TomBeech85/esphome-toshiba-hvac-controller/hardware/integrated/render_check.png

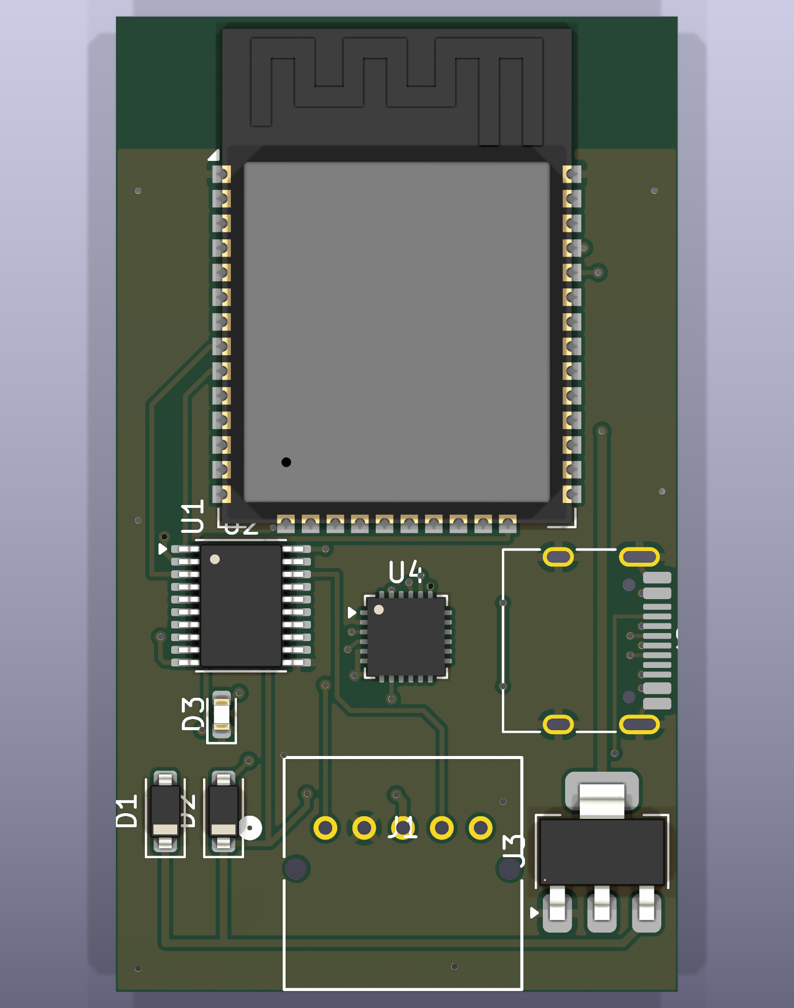
hardware/integrated/render_check.png
