TomBeech85/esphome-toshiba-hvac-controller/hardware/integrated/render_bottom.png

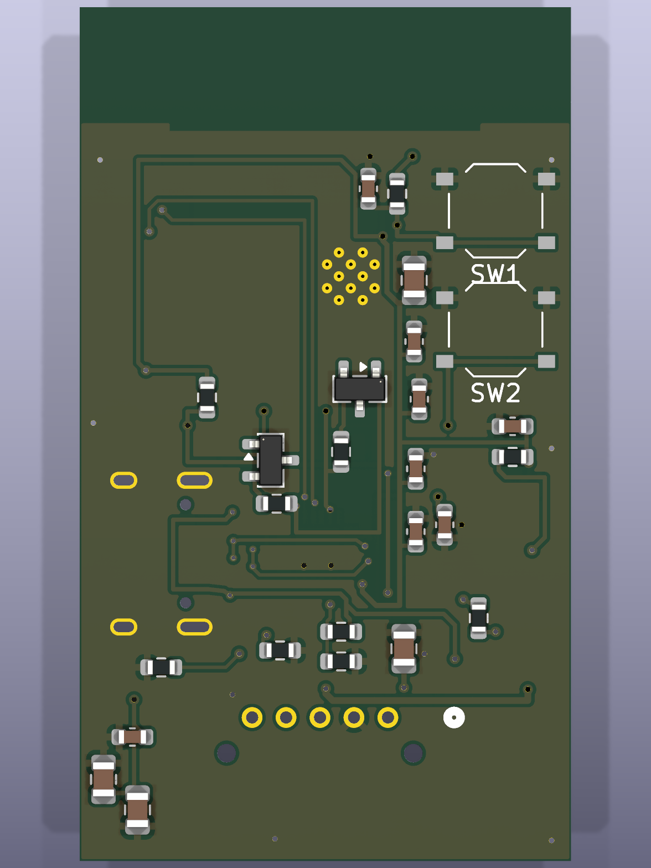
hardware/integrated/render_bottom.png
