TomBeech85/esphome-toshiba-hvac-controller/hardware/integrated/render_top.png

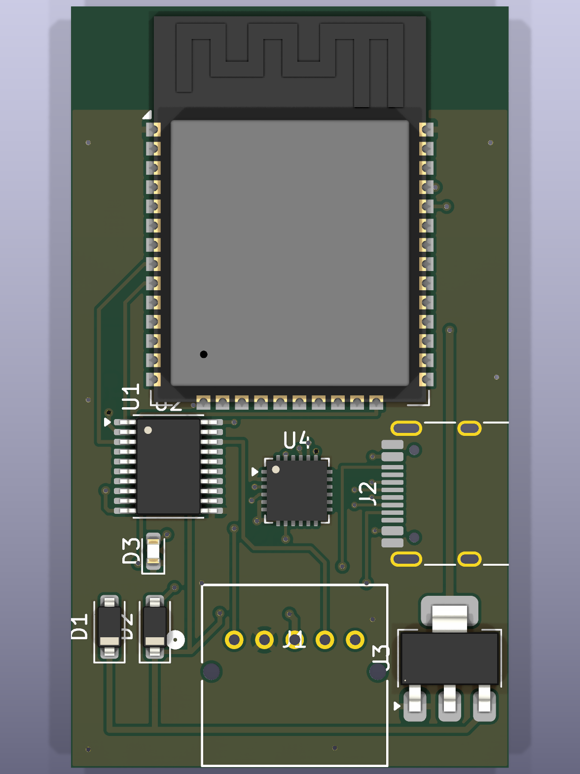
hardware/integrated/render_top.png
