TomBeech85/esphome-toshiba-hvac-controller/hardware/integrated/toshiba_hvac_esp32_integrated.kicad_pcb

## KiCad design hardware/integrated/toshiba_hvac_esp32_integrated.kicad_pcb (2026-08-09)

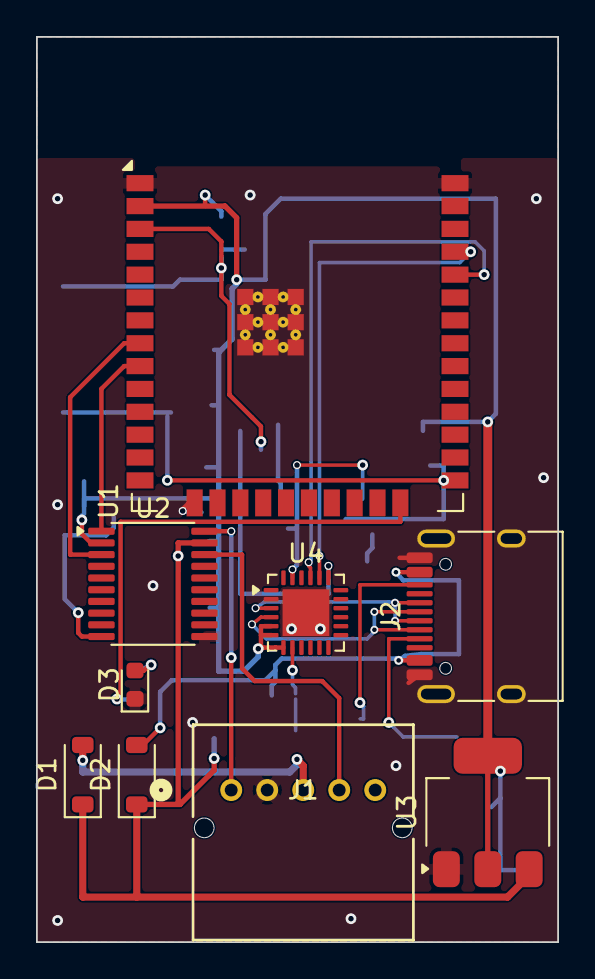
[picture p4: board toshiba_hvac_esp32_integrated.kicad_pcb from above]

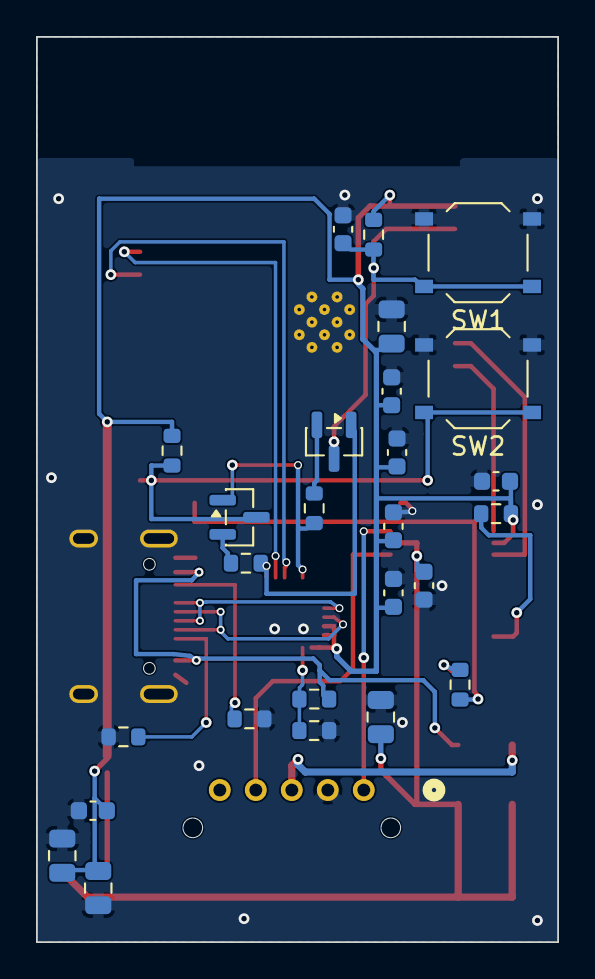
[picture p5: board toshiba_hvac_esp32_integrated.kicad_pcb from below]

Board: 2 copper layers, 29.0 x 50.3 mm, 35 parts (26 on the bottom side), 25 nets.

Parts:
C1, C2, C3, C4, C5, C6: 100nF; C_0603_1608Metric
C7, C8: 1uF; C_0603_1608Metric
C9, C10: 10uF; C_0805_2012Metric
C11, C12: 22uF; C_0805_2012Metric
D1, D2: B5819W; D_SOD-123
D3: LED_Red; LED_0603_1608Metric
J1: S05B-PASK-2LFSN; CONN_S05B-PASK-2_JST
J2: TYPE-C-31-M-12; USB_C_Receptacle_HRO_TYPE-C-31-M-12
Q1, Q2: S8050; SOT-23
R1, R2, R3, R4, R5: 10k; R_0603_1608Metric
R6, R7: 5.1k; R_0603_1608Metric
R8: 1k; R_0603_1608Metric
R9: 22k; R_0603_1608Metric
R10: 47k; R_0603_1608Metric
SW1: EN; SW_Push_1P1T_XKB_TS-1187A
SW2: BOOT; SW_Push_1P1T_XKB_TS-1187A
U1: ESP32-WROOM-32E-N8; ESP32-WROOM-32E
U2: TXS0108EPW; TSSOP-20_4.4x6.5mm_P0.65mm
U3: AMS1117-3.3; SOT-223-3_TabPin2
U4: CP2102N-A02-GQFN24; QFN-24-1EP_4x4mm_P0.5mm_EP2.6x2.6mm

Connections:
+3V3: C1.1, C2.1, C4.1, C5.1, C6.1, C8.1, C9.1, C10.1, C12.1, R1.1, R2.1, R3.1, U1.2, U2.2, U3.2, U4.5, U4.6, U4.7
+5V: C3.1, C11.1, D1.1, D2.1, U2.19, U3.3
+5V_AC: D1.2, J1.3
AC_RX: U1.8, U2.3
AC_TX: U1.9, U2.1
CC1: J2.A5, R6.1
CC2: J2.B5, R7.1
DTR: Q2.1, R4.1, U4.23
EN: C7.1, Q1.3, R1.2, SW1.1, U1.3
ESP_RX_5V: J1.4, U2.18
ESP_TX_5V: J1.1, U2.20
GND: C1.2, C2.2, C3.2, C4.2, C5.2, C6.2, C7.2, C8.2, C9.2, C10.2, C11.2, C12.2, D3.1, J1.2, J2.A1, J2.A12, J2.B1, J2.B12, J2.SH, R6.2, R7.2, R10.2, SW1.2, SW2.2, U1.1, U1.15, U1.38, U1.39, U2.11, U3.1, U4.2, U4.25
IO0: Q2.3, R2.2, SW2.1, U1.25
LED_A: D3.2, R8.2
LED_CTRL: R8.1, U1.24
Q1_B: Q1.2, R4.2
Q2_B: Q2.2, R5.2
RTS: Q1.1, R5.1, U4.19
SHIFT_OE: R3.2, U2.10
U0RXD: U1.34, U4.21
U0TXD: U1.35, U4.20
USB_DM: J2.A7, J2.B7, U4.4
USB_DP: J2.A6, J2.B6, U4.3
VBUS: D2.2, J2.A4, J2.A9, J2.B4, J2.B9, R9.1
VBUS_SENSE: R9.2, R10.1, U4.8
