TomBeech85/esphome-toshiba-hvac-controller/hardware/integrated/routes.py

"""Routing data for build_pcb.py — every track and via, hand-planned.

Coordinates are absolute board mm. "F"/"B" = front/back copper. Widths in mm.
Vias: (net, x, y, outer_diameter, drill).

Structure notes:
- J2 is flipped so the mating face is flush with the east board edge; its pads therefore sit at
  x 56.315 facing WEST, and escape through staggered via columns at x 54.95 (D+) and x 53.8 (D-).
- UART0/DTR/RTS leave U4's top row into a staggered via belt (y 61.3-62.3), then: TXD/RXD run
  north as a back-layer pair (x 50.75 / 50.375); DTR crosses to Q2 on a short front bridge at
  y 56.5; RTS drops south and hooks west to Q1.
- Q1/R4 live west of the UART walls; Q2/R5 east, next to U4.
- The +3V3 net ties its west spine to the east (U3/R2) side via a back run above the module's
  pad rows at y 41.5.
"""

F, B = "F", "B"

TRACKS = [
    # ── AC UART, front left margin ──
    ("AC_TX", F, 0.25, [(40.78, 50.8), (39.9, 50.8), (38.638, 52.062), (38.638, 59.975)]),
    ("AC_RX", F, 0.25, [(40.78, 49.53), (39.9, 49.53), (36.9, 52.53), (36.9, 61.275), (38.638, 61.275)]),
    # ── 5V-side UART down to the JST ──
    ("ESP_TX_5V", F, 0.25, [(44.362, 59.975), (45.85, 59.975)]),
    ("ESP_TX_5V", B, 0.25, [(45.85, 59.975), (45.85, 67.0), (45.847, 67.0)]),
    ("ESP_TX_5V", F, 0.25, [(45.847, 67.0), (45.847, 74.353)]),
    ("ESP_RX_5V", F, 0.25, [(44.362, 61.275), (46.45, 61.275), (46.45, 67.6), (47.15, 68.3), (50.9, 68.3), (51.847, 69.247), (51.847, 74.353)]),
    ("SHIFT_OE", F, 0.25, [(38.638, 65.825), (37.55, 65.825), (37.35, 65.625), (37.35, 64.5)]),
    ("SHIFT_OE", B, 0.25, [(37.35, 64.5), (36.6, 63.75), (36.6, 60.2), (38.9, 60.2), (39.325, 59.775), (39.325, 59.2)]),
    # ── status LED ──
    ("LED_CTRL", F, 0.25, [(55.245, 58.4), (55.245, 59.45), (39.7, 59.45), (39.7, 68.9), (39.5, 69.1), (39.5, 69.3)]),
    ("LED_CTRL", B, 0.25, [(39.5, 69.325), (40.5, 69.325)]),
    ("LED_A", F, 0.25, [(40.5, 67.713), (41.0, 67.713), (41.31, 67.4), (41.4, 67.4)]),
    ("LED_A", B, 0.25, [(41.4, 67.4), (40.9, 67.65)]),
    # ── IO0 ──
    ("IO0", F, 0.25, [(58.28, 57.15), (57.65, 57.15), (42.3, 57.15)]),
    ("IO0", B, 0.25, [(57.65, 57.15), (57.65, 56.325), (56.9, 56.325)]),
    ("IO0", B, 0.25, [(57.65, 57.15), (57.65, 59.3), (52.2, 59.3)]),
    ("IO0", B, 0.25, [(42.3, 57.15), (42.3, 53.6)]),
    ("IO0", B, 0.25, [(36.5, 53.375), (42.5, 53.375)]),
    # ── EN ──
    ("EN", F, 0.25, [(40.78, 43.18), (44.6, 43.18), (45.3, 43.88), (45.3, 45.35)]),
    ("EN", B, 0.25, [(45.3, 45.35), (45.3, 44.7)]),
    ("EN", B, 0.25, [(45.3, 45.35), (45.3, 46.0), (43.0, 46.0), (42.6, 46.4)]),
    ("EN", B, 0.25, [(36.5, 46.375), (42.5, 46.375)]),
    ("EN", B, 0.25, [(45.3, 44.325), (46.6, 44.325)]),
    ("EN", F, 0.25, [(45.3, 45.35), (45.3, 46.9), (45.75, 47.35), (45.75, 52.4), (47.0, 53.65), (47.5, 54.15), (47.5, 55.0)]),
    ("EN", B, 0.25, [(47.5, 55.0), (47.5, 55.45)]),
    # ── auto-reset: Q1/R4 west of the walls, Q2/R5 by U4 ──
    ("Q1_B", B, 0.25, [(48.45, 54.06), (48.45, 57.15), (48.6, 57.3), (48.6, 57.9)]),
    ("Q2_B", B, 0.25, [(53.688, 60.15), (53.688, 60.9), (53.4, 61.2), (53.4, 61.65)]),
    ("DTR", F, 0.2, [(49.25, 62.562), (49.25, 62.1)]),
    ("DTR", B, 0.25, [(49.25, 62.1), (49.5, 61.85), (49.5, 56.3)]),
    ("DTR", B, 0.25, [(49.5, 59.825), (49.0, 59.825)]),
    
    ("DTR", F, 0.2, [(49.5, 56.3), (53.15, 56.3)]),
    ("DTR", B, 0.2, [(53.15, 56.3), (53.15, 58.2)]),
    ("RTS", F, 0.2, [(51.25, 62.562), (51.25, 61.9)]),
    ("RTS", B, 0.25, [(51.25, 61.9), (51.25, 63.45), (46.35, 63.45), (46.35, 54.4)]),
    # ── UART0 to the USB bridge ──
    ("U0TXD", F, 0.2, [(50.75, 62.562), (50.75, 61.35)]),
    ("U0RXD", F, 0.2, [(50.25, 62.562), (50.25, 62.0), (50.15, 61.9), (50.15, 61.7)]),
    ("U0TXD", B, 0.2, [(50.75, 61.35), (50.75, 45.05), (58.55, 45.05), (59.15, 44.45)]),
    ("U0RXD", B, 0.2, [(50.15, 61.7), (50.284, 61.566), (50.284, 43.9), (59.4, 43.9), (59.9, 44.4), (59.9, 45.72)]),
    ("U0TXD", F, 0.25, [(58.28, 44.45), (59.15, 44.45)]),
    ("U0RXD", F, 0.25, [(58.28, 45.72), (59.9, 45.72)]),
    # ── USB data, U4 side ──
    ("USB_DP", F, 0.2, [(48.062, 64.25), (47.2, 64.25)]),
    ("USB_DM", F, 0.2, [(48.062, 64.75), (47.5, 64.75), (47.0, 65.15)]),
    # ── USB data, back lanes (J2 pads now at x 56.315, connector opening faces the east edge) ──
    ("USB_DP", B, 0.2, [(47.2, 64.25), (47.7, 63.9), (54.6, 63.9), (54.95, 63.95)]),
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
    ("GND", 43.15, 58.85, 0.45, 0.3),
    ("GND", 41.5, 63.0, 0.6, 0.3),
    ("GND", 43.7, 70.6, 0.6, 0.3),
    ("GND", 46.9, 41.3, 0.6, 0.3),
    ("GND", 63.2, 57.0, 0.6, 0.3),
    ("GND", 55.0, 73.0, 0.6, 0.3),
    ("GND", 49.2, 65.4, 0.6, 0.3),
    ("GND", 50.8, 65.4, 0.6, 0.3),
]
