TomBeech85/esphome-toshiba-hvac-controller/(commit log)

2026-08-08 docs: design spec for integrated ESP32 board
2026-08-08 docs: implementation plan for integrated ESP32 board
2026-08-08 hw: extract upstream outline and J1 mapping for integrated board
2026-08-08 hw: verified JLCPCB BOM for integrated board
    Every LCSC number checked against the live JLCPCB parts catalogue.
    LED changed from green (C72043, Vf 3.3V - too high for a 3.3V GPIO)
    to red KT-0603R (C2286, Vf ~2V). CP2102N is the -GQFN24R reel variant
    C969151. VBUS divider per Silabs self-powered reference: 22k top, 47k
    bottom, giving 3.4V at the sense pin.
    [bom.csv]
2026-08-08 hw: integrated board schematic, ERC clean, netlist asserted
    Schematic authored by generate_sch.py: symbols extracted from the
    KiCad 10 libraries, every pin bound to the plan's net map by pin
    number with pin-name assertions. ERC 0 violations. verify_netlist.py
    independently asserts the J1 mapping, shifter channel pairing, UART
    cross-connect, auto-reset topology, strapping and power path.
    [toshiba_hvac_esp32_integrated.kicad_sch]
2026-08-09 hw: integrated board layout complete - DRC clean, parity verified
    Placement and full manual routing via build_pcb.py + routes.py.
    DRC: 0 errors, 0 unconnected (10 cosmetic silk warnings remain).
    verify_netlist.py --pcb: 173 schematic nodes, 0 mismatches.
    JLCPCB 2-layer rules: 0.127mm clearance, 0.3mm min via drill,
    0.2mm module EP thermal vias, 0.1mm copper-to-edge for the USB-C.
    [toshiba_hvac_esp32_integrated.kicad_pcb]
2026-08-09 hw: JLCPCB production files + README for integrated board
    [positions.csv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]
2026-08-09 fix(hw): USB-C mating face pointed into the board
    J2's signal pins sat east of its shell posts, so the connector opening
    faced the board interior instead of the east edge - the port could not
    have been plugged in. Found in JLCPCB's placement preview; invisible in
    KiCad's own render because the library ships no 3D model for this part.
    Rotated J2 180deg and moved it east so the body is flush with the board
    outline. Its pads move from x 62.945 to x 56.315, so the whole USB block
    is re-routed: staggered D+/D- via columns west of the pad field, CC1 and
    CC2 escaping south to relocated pulldowns, and VBUS looping east under
    the connector body to tie both power pads.
    build_pcb.py now asserts the o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
    [positions.csv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]
